ryanmccormickdev/PigeonVision/hardware/rf-frontend/pigeonvision_pa/3d/Molex_Micro-Fit_3.0_43045-0418_2x02-1MP_P3.00mm_Vertical.step

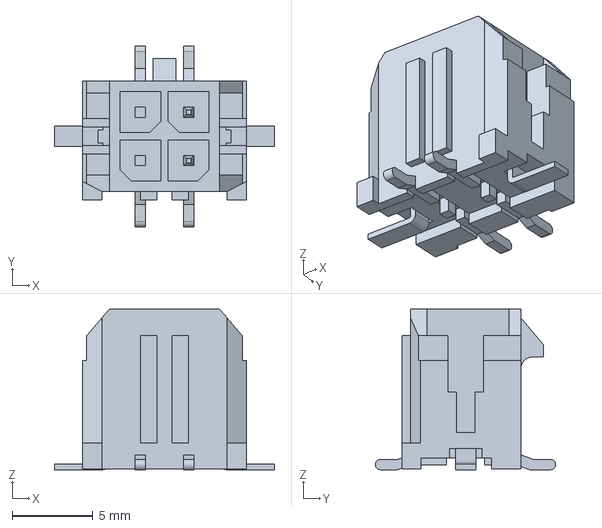
[picture p1: CAD file, 2026-11-02]
hardware/rf-frontend/pigeonvision_pa/3d/Molex_Micro-Fit_3.0_43045-0418_2x02-1MP_P3.00mm_Vertical.step
13.7 x 11.2 x 9.96 mm
