ryanmccormickdev/PigeonVision/hardware/rf-frontend/pigeonvision_pa/pigeonvision_pa.kicad_pcb

## KiCad design hardware/rf-frontend/pigeonvision_pa/pigeonvision_pa.kicad_pcb (2026-11-03)

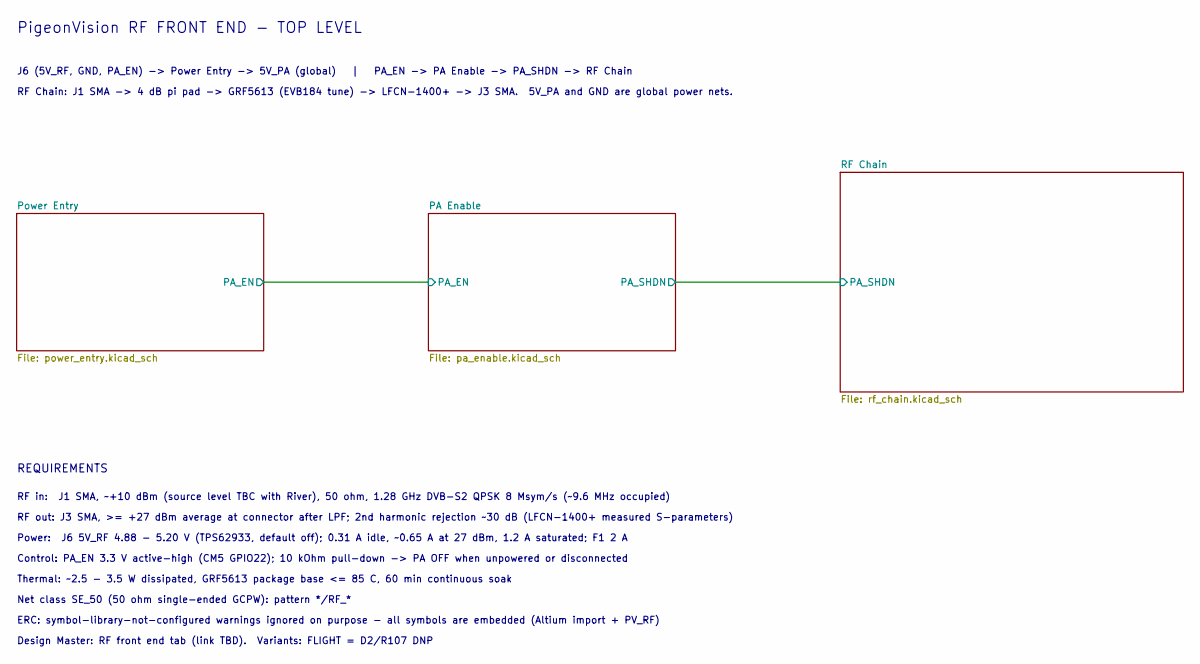
[picture p2: schematic pigeonvision_pa.kicad_sch, PigeonVision RF Front End - GRF5613 Power Amplifier]

Notes on the sheet:
Net class SE_50 (50 ohm single-ended GCPW): pattern */RF_*
Design Master: RF front end tab (link TBD). Variants: FLIGHT = D2/R107 DNP
Thermal: ~2.5 - 3.5 W dissipated, GRF5613 package base <= 85 C, 60 min continuous soak
Power: J6 5V_RF 4.88 - 5.20 V (TPS62933, default off); 0.31 A idle, ~0.65 A at 27 dBm, 1.2 A saturated; F1 2 A
REQUIREMENTS
PigeonVision RF FRONT END - TOP LEVEL
RF out: J3 SMA, >= +27 dBm average at connector after LPF; 2nd harmonic rejection ~30 dB (LFCN-1400+ measured S-parameters)
RF in: J1 SMA, ~+10 dBm (source level TBC with River), 50 ohm, 1.28 GHz DVB-S2 QPSK 8 Msym/s (~9.6 MHz occupied)
Control: PA_EN 3.3 V active-high (CM5 GPIO22); 10 kOhm pull-down -> PA OFF when unpowered or disconnected
RF Chain: J1 SMA -> 4 dB pi pad -> GRF5613 (EVB184 tune) -> LFCN-1400+ -> J3 SMA. 5V_PA and GND are global power nets.
ERC: symbol-library-not-configured warnings ignored on purpose - all symbols are embedded (Altium import + PV_RF)
J6 (5V_RF, GND, PA_EN) -> Power Entry -> 5V_PA (global) | PA_EN -> PA Enable -> PA_SHDN -> RF Chain

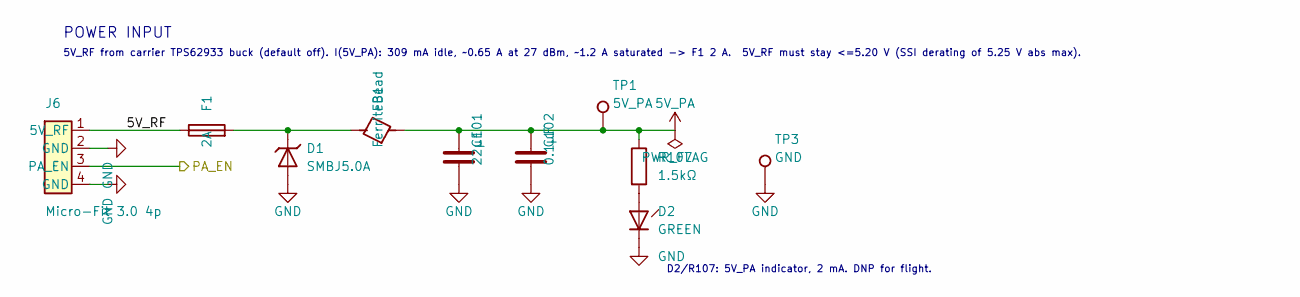
[picture p3: schematic power_entry.kicad_sch, PigeonVision RF Front End - Power Entry]

Parts:
C101: 22µF; C_1206_3216Metric; MPN TBD; LCSC TBD
C102: 0.1µF; C_0402_1005Metric; MPN GRM155R71C104KA88D; LCSC TBD
D1: SMBJ5.0A; D_SMB; MPN SMBJ5.0A; LCSC TBD
D2: GREEN; LED_0805_2012Metric; MPN LTST-C170KGKT; LCSC TBD
F1: 2A; Fuse_1206_3216Metric; MPN 0466002.NR; LCSC TBD
FB1: FerriteBead; L_1206_3216Metric; MPN TBD; LCSC TBD
J6: Micro-Fit 3.0 4p; Molex_Micro-Fit_3.0_43045-0418_2x02-1MP_P3.00mm_Vertical; MPN 0430450418; LCSC TBD
R107: 1.5kΩ; R_0402_1005Metric; MPN RC0402FR-071K5L; LCSC TBD
TP1: 5V_PA; TestPoint_Pad_D1.0mm
TP3: GND; TestPoint_Pad_D1.0mm

Connections:
5V_PA: C101.2, C102.2, FB1.2, R107.1, TP1.1 (1_1); also elsewhere on the board
/PA Enable/PA_EN: J6.3 (PA_EN); also elsewhere on the board
/Power Entry/5V_RF: F1.1, J6.1 (5V_RF)
GND: C101.1, C102.1, D1.2 (A), D2.1, J6.2 (GND), J6.4 (GND), TP3.1 (1_1); also elsewhere on the board
unnamed: D1.1 (K), F1.2, FB1.1
unnamed: D2.2, R107.2

Notes on the sheet:
POWER INPUT
5V_RF from carrier TPS62933 buck (default off). I(5V_PA): 309 mA idle, ~0.65 A at 27 dBm, ~1.2 A saturated -> F1 2 A. 5V_RF must stay <=5.20 V (SSI derating of 5.25 V abs max).
D2/R107: 5V_PA indicator, 2 mA. DNP for flight.

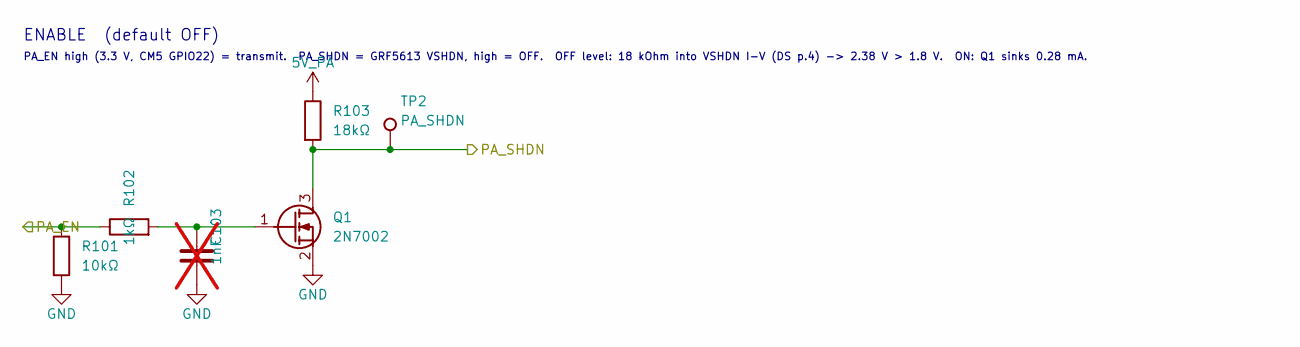
[picture p4: schematic pa_enable.kicad_sch, PigeonVision RF Front End - PA Enable]

Parts:
C103: 1nF; C_0402_1005Metric; MPN GRM155R71H102KA01D; LCSC TBD; not fitted
Q1: 2N7002; SOT-23; MPN 2N7002KT1G; LCSC TBD
R101: 10kΩ; R_0402_1005Metric; MPN RC0402FR-0710KL; LCSC TBD
R102: 1kΩ; R_0402_1005Metric; MPN RC0402FR-071KL; LCSC TBD
R103: 18kΩ; R_0402_1005Metric; MPN RC0402FR-0718KL; LCSC TBD
TP2: PA_SHDN; TestPoint_Pad_D1.0mm

Connections:
5V_PA: R103.1; also elsewhere on the board
/PA Enable/PA_EN: R101.1, R102.1; also elsewhere on the board
/PA Enable/PA_SHDN: Q1.3 (D), R103.2, TP2.1 (1_1); also elsewhere on the board
GND: C103.1, Q1.2 (S), R101.2; also elsewhere on the board
unnamed: C103.2, Q1.1 (G), R102.2

Notes on the sheet:
PA_EN high (3.3 V, CM5 GPIO22) = transmit. PA_SHDN = GRF5613 VSHDN, high = OFF. OFF level: 18 kOhm into VSHDN I-V (DS p.4) -> 2.38 V > 1.8 V. ON: Q1 sinks 0.28 mA.
ENABLE (default OFF)

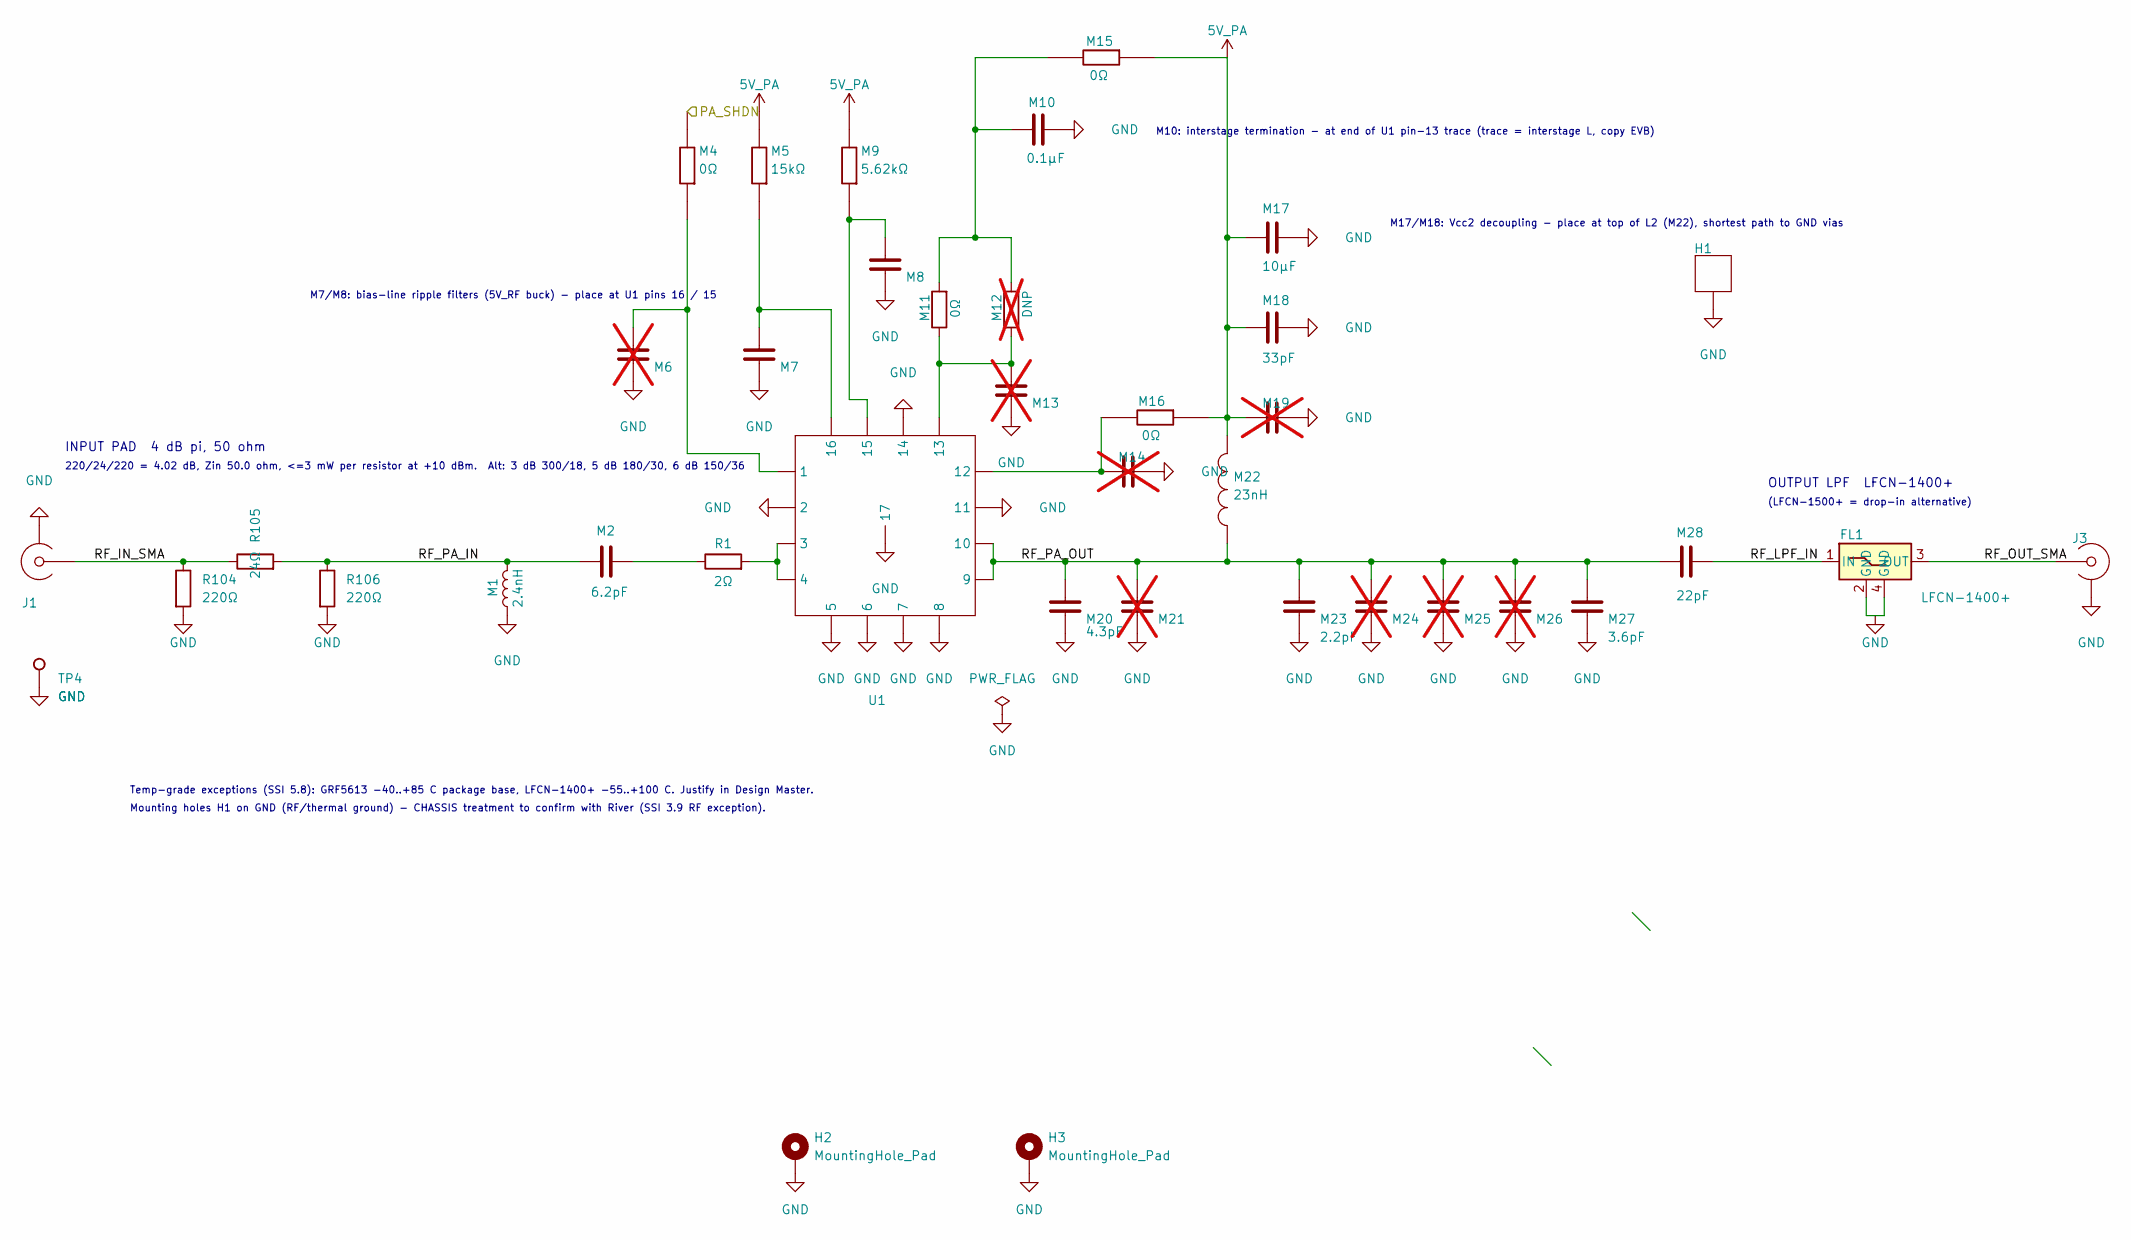
[picture p5: schematic rf_chain.kicad_sch, PigeonVision RF Front End - RF Chain]

Parts:
FL1: LFCN-1400+; MiniCircuits_FV1206_LFCN; MPN LFCN-1400+; LCSC TBD
H1: Heatsink; Heatsink_wFid
H2, H3: MountingHole_Pad; MountingHole_3.2mm_M3_Pad
J1, J3: SMA; SMA Round_Pin_RevC; MPN TBD
M1: 2.4nH; 0402_20x26x22; MPN LQG15HS2N4S02D
M2: 6.2pF; 0402_20x30x18; MPN GJM1555C1H6R2BB01D
M4, M11, M15, M16: 0Ω; 0402_26x26x20; MPN RC0402JR-070RL
M5: 15kΩ; 0402_26x26x20; MPN RC0402FR-0715KL
M6, M13, M14, M19: DNP; 0402_20x26x16; not fitted
M7, M8, M10: 0.1µF; 0402_20x26x16; MPN GRM155R71C104KA88D
M9: 5.62kΩ; 0402_26x26x20; MPN RC0402FR-075K62L
M12: DNP; 0402_26x26x20; not fitted
M17: 10µF; 0402_20x26x16; MPN TBD
M18: 33pF; 0402_20x26x16; MPN GJM1555C1H330GB01D
M20: 4.3pF; 0402_20x26x22; MPN GJM1555C1H4R3BB01D
M21, M24, M25, M26: DNP; 0402_20x26x22; not fitted
M22: 23nH; 0603_26x40x30; MPN 0908SQ-23NGLC
M23: 2.2pF; 0402_20x26x22; MPN GJM1555C1H2R2BB01D
M27: 3.6pF; 0402_20x26x22; MPN GJM1555C1H3R6BB01D
M28: 22pF; 0402_20x30x18; MPN GJM1555C1H220GB01D
R1: 2Ω; R_0402_1005Metric; MPN RC0402FR-072RL
R104, R106: 220Ω; R_0402_1005Metric; MPN RC0402FR-07220RL; LCSC TBD
R105: 24Ω; R_0402_1005Metric; MPN RC0402FR-0724RL; LCSC TBD
TP4: GND; TestPoint_Pad_D1.0mm
U1: GRF5613; QFN16_3x3mm_RevG; MPN GRF5613

Connections:
5V_PA: M5.2, M9.2, M15.1, M16.1, M17.2, M18.2, M19.2, M22.2; also elsewhere on the board
/PA Enable/PA_SHDN: M4.2; also elsewhere on the board
/RF Chain/RF_IN_SMA: J1.1, R104.1, R105.1
/RF Chain/RF_LPF_IN: FL1.1 (IN), M28.1
/RF Chain/RF_OUT_SMA: FL1.3 (OUT), J3.1
/RF Chain/RF_PA_IN: M1.2, M2.2, R105.2, R106.1
/RF Chain/RF_PA_OUT: M20.2, M21.2, M22.1, M23.2, M24.2, M25.2, M26.2, M27.2, M28.2, U1.9, U1.10
GND: FL1.2 (GND), FL1.4 (GND), H1.1 (1_1), H2.1 (1_1), H3.1 (1_1), J1.2, J3.2, M1.1, M6.1, M7.1, M8.1, M10.1, M13.1, M14.1, M17.1, M18.1, M19.1, M20.1, M21.1, M23.1, M24.1, M25.1, M26.1, M27.1, R104.2, R106.2, TP4.1 (1_1), U1.2, U1.5, U1.6, U1.7, U1.8, U1.11, U1.14, U1.17; also elsewhere on the board
unnamed: M2.1, R1.1
unnamed: M4.1, M6.2, U1.1
unnamed: M5.1, M7.2, U1.16
unnamed: M8.2, M9.1, U1.15
unnamed: M10.2, M11.2, M12.2, M15.2
unnamed: M11.1, M12.1, M13.2, U1.13
unnamed: M14.2, M16.2, U1.12
unnamed: R1.2, U1.3, U1.4

Notes on the sheet:
M10: interstage termination - at end of U1 pin-13 trace (trace = interstage L, copy EVB)
(LFCN-1500+ = drop-in alternative)
M17/M18: Vcc2 decoupling - place at top of L2 (M22), shortest path to GND vias
M7/M8: bias-line ripple filters (5V_RF buck) - place at U1 pins 16 / 15
Temp-grade exceptions (SSI 5.8): GRF5613 -40..+85 C package base, LFCN-1400+ -55..+100 C. Justify in Design Master.
OUTPUT LPF LFCN-1400+
220/24/220 = 4.02 dB, Zin 50.0 ohm, <=3 mW per resistor at +10 dBm. Alt: 3 dB 300/18, 5 dB 180/30, 6 dB 150/36
INPUT PAD 4 dB pi, 50 ohm
Mounting holes H1 on GND (RF/thermal ground) - CHASSIS treatment to confirm with River (SSI 3.9 RF exception).

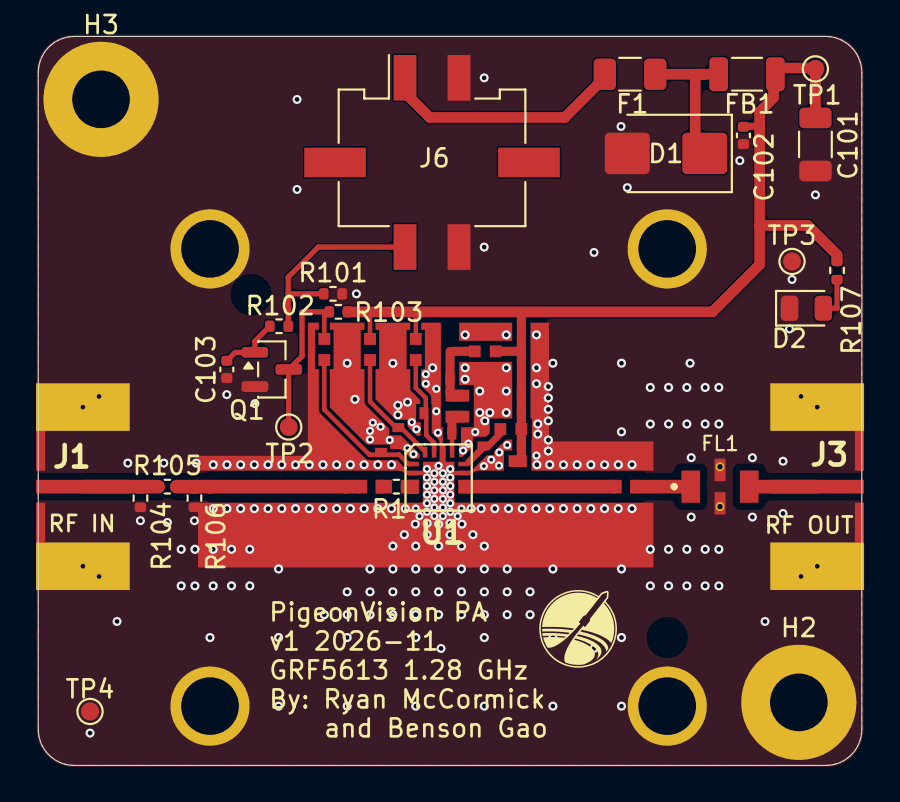
[picture p6: board pigeonvision_pa.kicad_pcb from above]

Board: 2 copper layers, 45.8 x 40.5 mm, 55 parts (0 on the bottom side), 21 nets.
