ryanmccormickdev/PigeonVision/(commit log)

2026-11-02 first board design
    [Molex_Micro-Fit_3.0_43045-0418_2x02-1MP_P3.00mm_Vertical.step, pa_enable.kicad_sch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]
2026-11-03 new rogers stackup and mounting holes
    [pa_enable.kicad_sch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]
